lozengedrop/chouchou_flight/case/case.stl

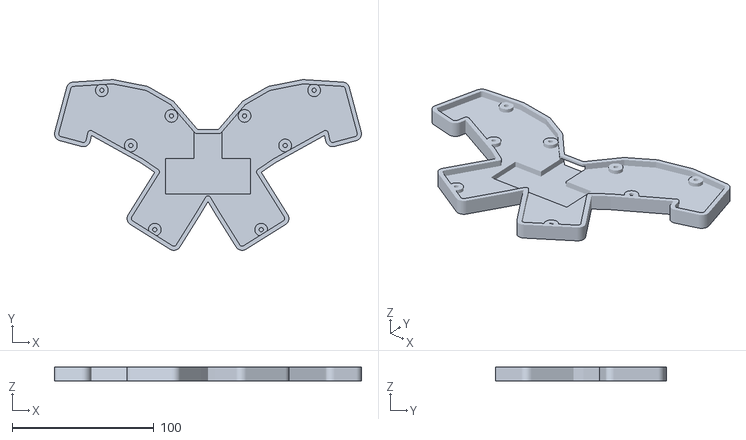
[picture p1: CAD file, 2026-06-13]
case/case.stl
216.5 x 120.4 x 9.60
