lozengedrop/chouchou_flight/kicad/chouchou.kicad_pcb

## KiCad design kicad/chouchou.kicad_pcb (2026-06-16)

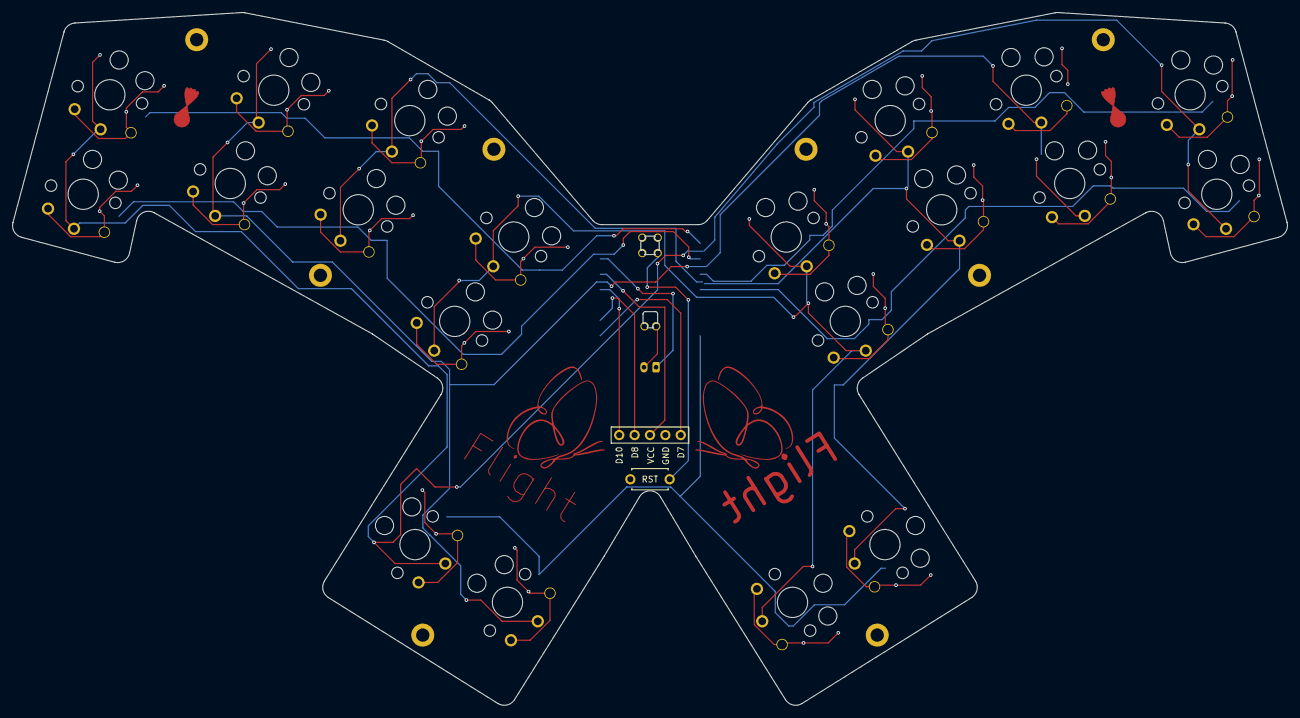
[picture p2: board chouchou.kicad_pcb from above]

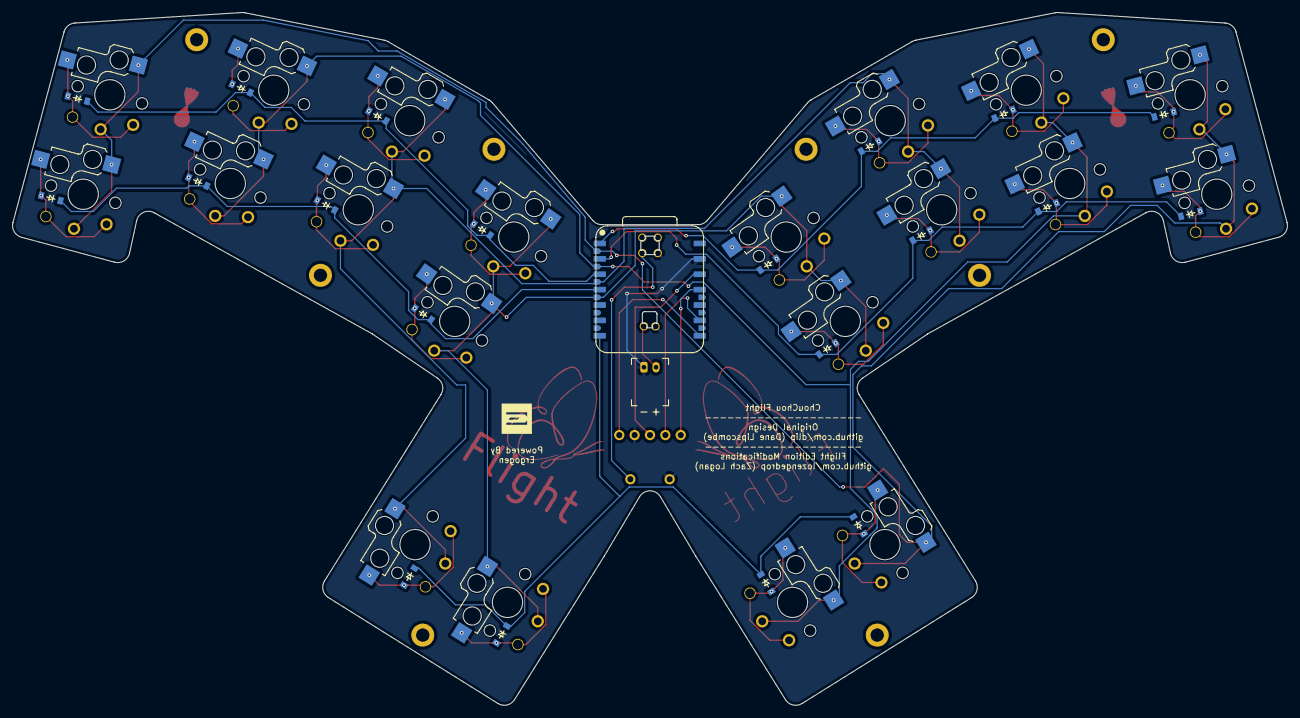
[picture p3: board chouchou.kicad_pcb from below]

Board: 2 copper layers, 210.5 x 114.4 mm, 52 parts (42 on the bottom side), 30 nets.

Parts:
D1, D2, D3, D4, D5, D6, D7, D8, D9, D10, D11, D12, D13, D14, D15, D16, D17, D18, D19, D20: diode_tht_sod123
DISP1: display_nice_view
H1, H2, H3, H4, H5, H6, H7, H8: mounting_hole_plated
JST1: battery_connector_jst_ph_2
LOGO1: utility_ergogen_logo
RST1: reset_switch_tht_top
S1, S2, S3, S4, S5, S6, S7, S8, S9, S10, S11, S12, S13, S14, S15, S16, S17, S18, S19, S20: switch_choc_v1_v2

Connections:
D0: D2.1, D4.1, D6.1, D8.1
D1: D1.1, D3.1, D5.1, D7.1
D2: D12.1, D14.1, D16.1, D18.1
D3: D11.1, D13.1, D15.1, D17.1
D6: D9.1, D10.1, D19.1, D20.1
D11: S1.1, S1.2, S2.1, S2.2, S9.1, S9.2, S10.1, S10.2, S17.1, S17.2
D12: S3.1, S3.2, S4.1, S4.2, S11.1, S11.2, S12.1, S12.2, S18.1, S18.2
D13: S5.1, S5.2, S6.1, S6.2, S13.1, S13.2, S14.1, S14.2, S19.1, S19.2
D14: S7.1, S7.2, S8.1, S8.2, S15.1, S15.2, S16.1, S16.2, S20.1, S20.2
GND: DISP1.4, JST1.1, RST1.2
index_bottom: D7.2, S7.1, S7.2
index_top: D8.2, S8.1, S8.2
inner_cluster: D9.2, S17.1, S17.2
middle_bottom: D5.2, S5.1, S5.2
middle_top: D6.2, S6.1, S6.2
mirror_index_bottom: D17.2, S15.1, S15.2
mirror_index_top: D18.2, S16.1, S16.2
mirror_inner_cluster: D19.2, S19.1, S19.2
mirror_middle_bottom: D15.2, S13.1, S13.2
mirror_middle_top: D16.2, S14.1, S14.2
mirror_outer_cluster: D20.2, S20.1, S20.2
mirror_pinky_bottom: D11.2, S9.1, S9.2
mirror_pinky_top: D12.2, S10.1, S10.2
mirror_ring_bottom: D13.2, S11.1, S11.2
mirror_ring_top: D14.2, S12.1, S12.2
outer_cluster: D10.2, S18.1, S18.2
pinky_bottom: D1.2, S1.1, S1.2
pinky_top: D2.2, S2.1, S2.2
ring_bottom: D3.2, S3.1, S3.2
ring_top: D4.2, S4.1, S4.2
