lozengedrop/chouchou_flight/(commit log)

2026-06-11 Update config.yaml
    PCB wireless support: xiao ble plus mcu, nice!view display, & battery jst.
    ceoloide ergogen footprints.
    adjust mounting hole positions slightly to avoid hotswap conflicts.
    [config.yaml]
2026-06-11 Space for battery
    Move jst and add pockets in case for battery and jst (also make case thicker to accomidate and reduce standoff height so pcb sits closer to base)
2026-06-12 move battery jst back to center to hide it under the display
2026-06-13 Add reset switch to pcb & mcu pocket in case
2026-06-13 Update case.stl to support wireless (thicker base w/ pockets for battery & mcu)
    [case.stl]
2026-06-16 remove unused footprints & add footprint for xiao
2026-06-16 updated PDB (without images)
    [chouchou.kicad_pcb, chouchou.kicad_sch]
2026-06-16 Add graphics to the pcb
    [chouchou.kicad_pcb]
2026-06-16 Gerber update
    [chouchou-B_Cu.gbl, chouchou-B_Mask.gbs, chouchou-B_Silkscreen.gbo, chouchou-Edge_Cuts.gm1, chouchou-F_Cu.gtl, chouchou-F_Mask.gts, chouchou-F_Silkscreen.gto, chouchou-NPTH.drl]
